isabella232/hw_microRusEfi/microRusEfi.kicad_pcb

## KiCad design microRusEfi.kicad_pcb (2019-09-02)

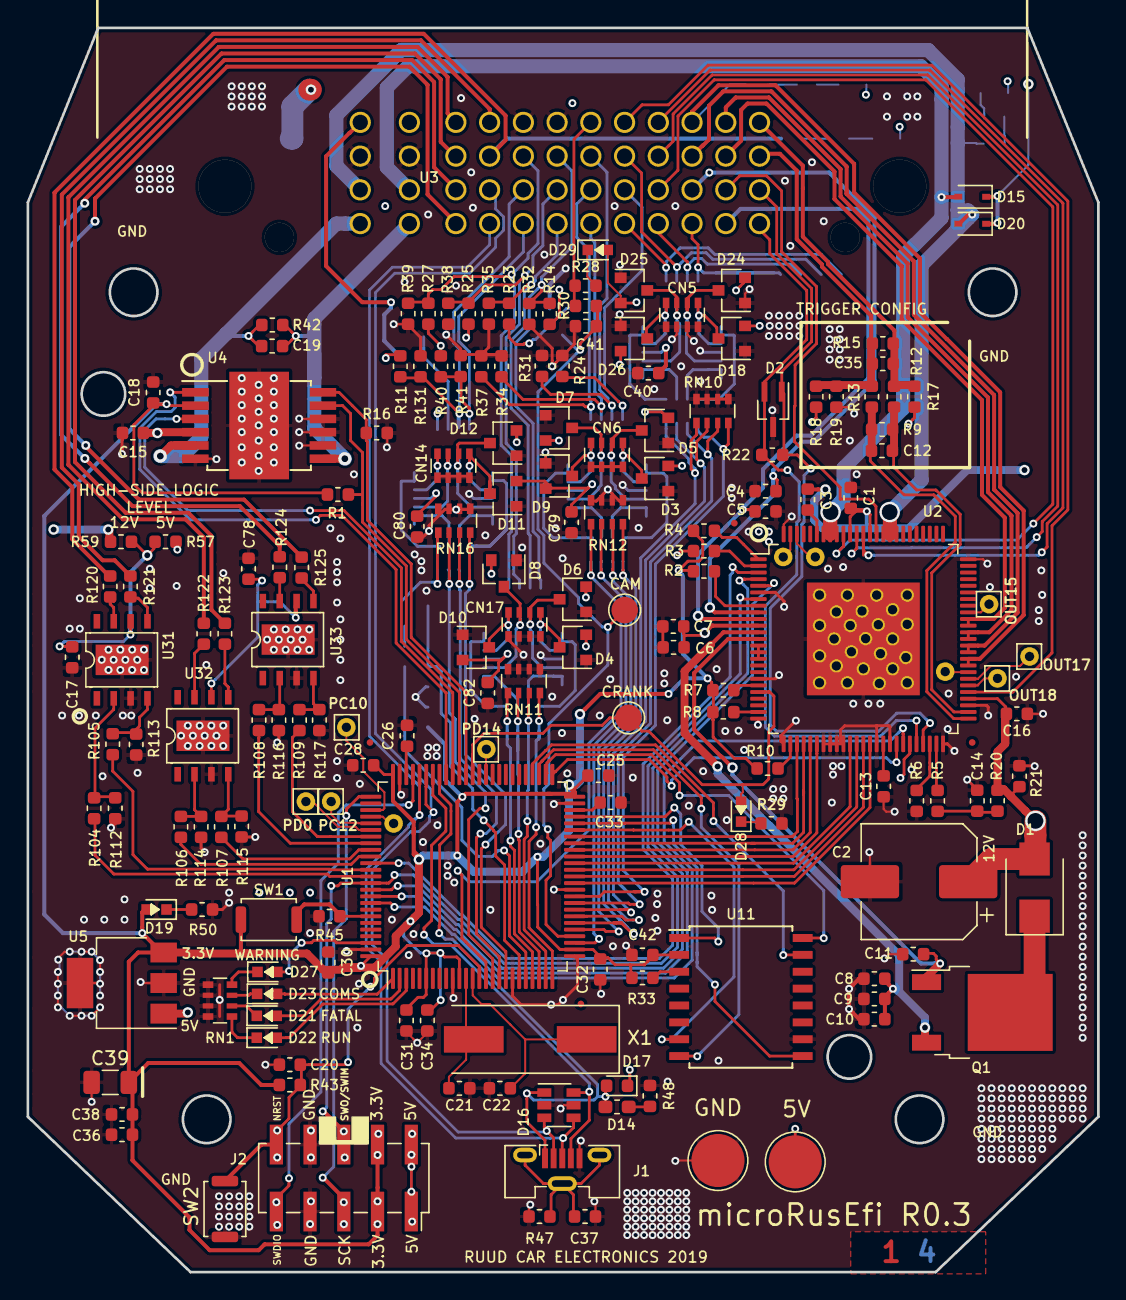
[picture p1: board microRusEfi.kicad_pcb from above]

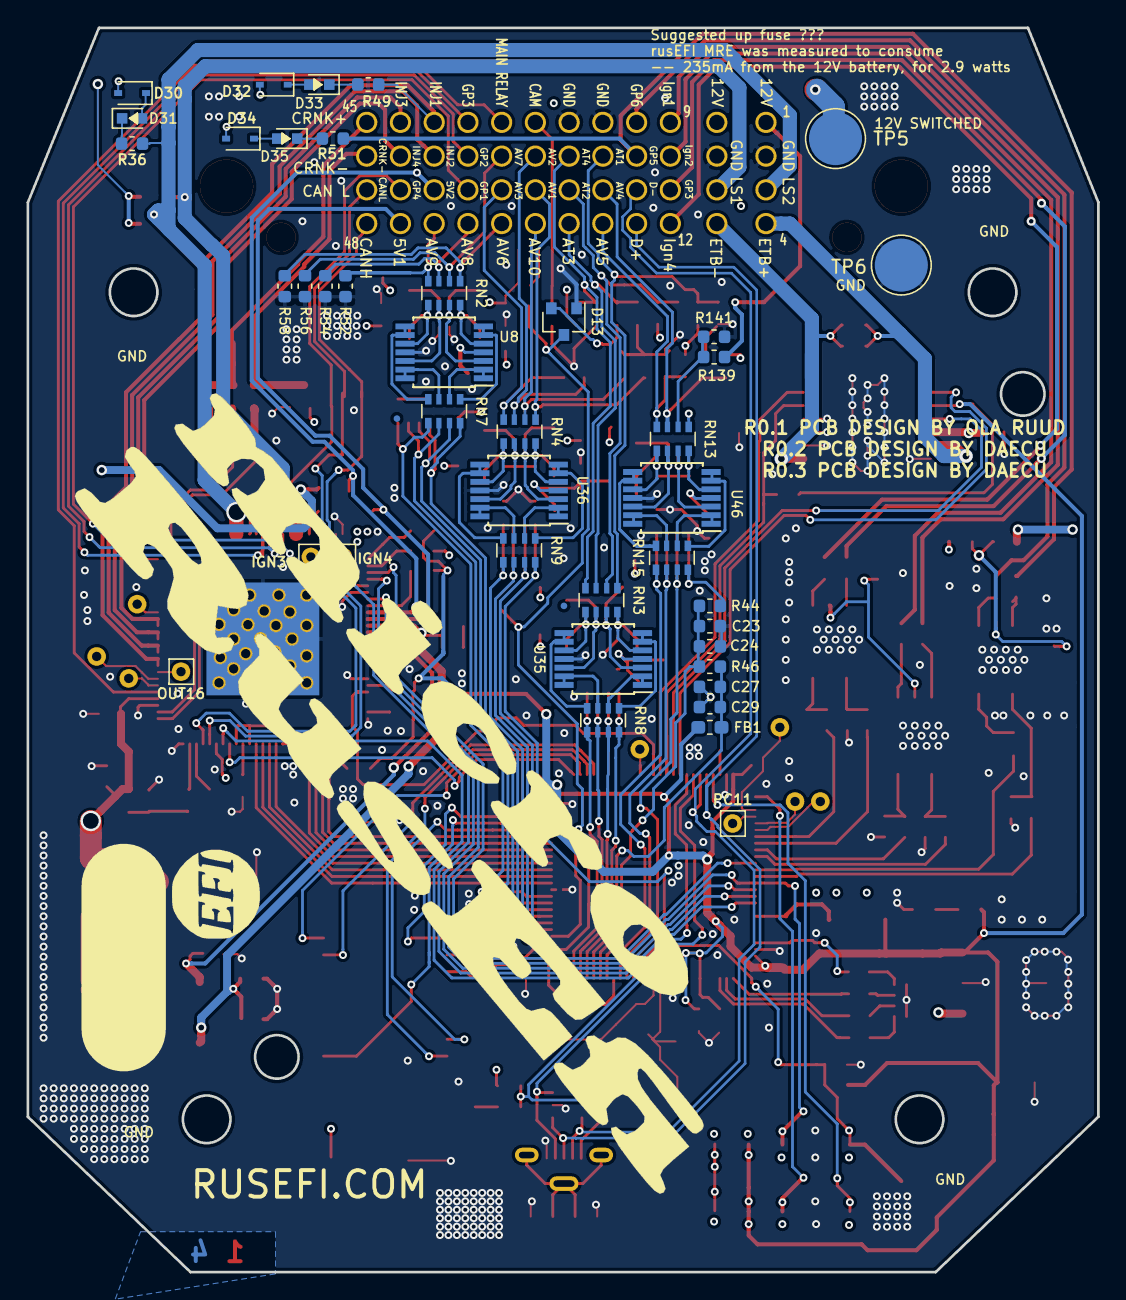
[picture p2: board microRusEfi.kicad_pcb from below]

Board: 4 copper layers, 80.6 x 93.7 mm, 222 parts (44 on the bottom side), 202 nets.

Parts:
C1, C6, C10, C13, C14, C15, C16, C18, C37, C38, C42: 100nF; C_0603_1608Metric
C2: 100UF 50V; CP_Elec_8x10.5
C3, C11: 4.7nF; C_0603_1608Metric
C4, C5: 470nF; C_0603_1608Metric
C7, C8, C9: 10uF; C_0603_1608Metric
C12, C35, C41: 1nF; C_0603_1608Metric
C17, C19, C20, C24, C28, C29, C30, C31, C32, C33, C34, C40, C78, C79, C80, C82: 10nF; C_0603_1608Metric
C21, C22: 4.7pF; C_0603_1608Metric
C23, C27, C36: 1uF; C_0603_1608Metric
C25, C26: 2.2uF; C_0603_1608Metric
C39: 15uF; C_1206_3216Metric
CN5, CN6, CN14, CN17: 10nF; R_Array_Convex_4x0603
D1: MBRS3200T3G; D_SMB
D2: PESD1CAN-UX; SOT-323_SC-70_Handsoldering
D3, D4, D5, D6, D7, D8, D9, D10, D11, D12, D13, D18, D24, D25, D26: BAS70-04; SOT-23
D14: LED-GREEN; C_0603_1608Metric_Pad1.05x0.95mm_HandSolder
D15, D20, D30, D32, D34: NSR0530HT; D_SOD-323
D16: ESDA6V1BC6; SOT-23-6
D17: DIODESCH; D_0603_1608Metric
D19, D21, D31, D33, D35: LED-RED; LED-0603-rusEFI
D22: LED-GRN; LED-0603-rusEFI
D23, D28, D29: LED-BLUE; LED-0603-rusEFI
D27: LED-ORG; LED-0603-rusEFI
FB1: FILTER; R_0603_1608Metric_Pad1.05x0.95mm_HandSolder
FID1, FID2, FID3, FID4, FID5, FID6: Fiducial; Fiducial_0.5mm_Mask1mm
IGN3: IGN3; Pin_D0.7mm_L6.5mm_W1.8mm_FlatFork
IGN4: IGN4; Pin_D0.7mm_L6.5mm_W1.8mm_FlatFork
J1: USB_B_Micro; USB_Micro-B_Molex-105133-0031
J2: Conn_02x05_Odd_Even; PinSocket_2x05_P2.54mm_Vertical_SMD
LOGO1: DNP; LogoMRE
LOGO2: DNP; LOGO
NT1, NT2: Net-Tie_2; Net-Tie_2_8.5mil
OUT15: OUT15; Pin_D0.7mm_L6.5mm_W1.8mm_FlatFork
OUT16: OUT16; Pin_D0.7mm_L6.5mm_W1.8mm_FlatFork
OUT17: OUT17; Pin_D0.7mm_L6.5mm_W1.8mm_FlatFork
OUT18: OUT18; Pin_D0.7mm_L6.5mm_W1.8mm_FlatFork
PC10: PC10; Pin_D0.7mm_L6.5mm_W1.8mm_FlatFork
PC11: PC11; Pin_D0.7mm_L6.5mm_W1.8mm_FlatFork
PC12: PC12; Pin_D0.7mm_L6.5mm_W1.8mm_FlatFork
PD0: PD0; Pin_D0.7mm_L6.5mm_W1.8mm_FlatFork
PD14: PD14; Pin_D0.7mm_L6.5mm_W1.8mm_FlatFork
Q1: IPD30N06S2L-23; TO-252-2
R1, R12, R13, R16, R33, R43, R45, R141: 10k; R_0603_1608Metric
R2, R3, R4, R8, R10, R42: 4.7k; R_0603_1608Metric
R5, R6, R7, R44, R59: 0R; R_0603_1608Metric
R9: 5.11k; R_0603_1608Metric
R11, R17, R18, R19, R40, R46, R57: DNP; R_0603_1608Metric
R14, R20, R21, R23, R25, R27: 2.7k; R_0603_1608Metric
R15: 15k; R_0603_1608Metric
R22: 120; R_0603_1608Metric
R24, R31, R32, R34, R35, R37, R38, R39, R41, R52, R54, R56, R58, R131: 500k; R_0603_1608Metric
R28: 2.2k; R_0603_1608Metric
R29, R36, R48, R49, R51, R112, R113, R114, R115, R116, R117: 1k; R_0603_1608Metric
R30: 33k; R_0603_1608Metric
R47: 100k; R_0603_1608Metric
R50: 680; R_0603_1608Metric
R104, R105, R106, R107, R108, R109: 20R; R_0603_1608Metric
R120, R121, R122, R123, R124, R125: 100; R_0603_1608Metric
R139: 39k; R_0603_1608Metric
RN1, RN7, RN8, RN9, RN15: 1k; R_Array_Convex_4x0603
RN2, RN3, RN4, RN13: 10k; R_Array_Convex_4x0603
RN10, RN11, RN12, RN16: 1.5k; R_Array_Convex_4x0603
SW1, SW2: SW_Push; SW_Push_SPST_NO_Alps_SKRK
TP1, TP5: 5V; TestPoint_Pad_D4.0mm
TP2, TP6: GND; TestPoint_Pad_D4.0mm
TP3, TP4: TP; TestPoint_Pad_D2.0mm
U1: STM32F767VITx; LQFP-100_14x14mm_P0.5mm
U2: TLE8888QK; LQFP-100_14x14mm_P0.5mm_THERMAL
U3: Molex_48_pin; Molex_48
U4: TLE9201SG; Infineon_PG-DSO-12-11
U5: LM2937; SOT-223
U8, U35, U36, U46: MCP6004; TSSOP-14_4.4x5mm_P0.65mm
U11: IS25WP256D-xM; SOIC-16W_7.5x10.3mm_P1.27mm
U31, U32, U33: TC4427; DFN-8-1EP_6x5mm_P1.27mm_EP4x2mm
X1: 8MHz; Crystal_SMD_HC49-SD

Connections:
/5V: C6.1, C7.1, C40.1, C78.1, C79.1, C80.1, C82.1, D3.2, D4.2, D5.2, D6.2, D7.2, D8.2, D9.2, D10.2, D11.2, D12.2, D13.2, D17.1, D18.2, D24.2, D25.2, D26.2, D29.2, D30.2, D32.2, D34.2, J2.1, J2.2, R3.2, R11.2, R14.2, R17.1, R18.1, R23.2, R25.2, R27.2, R40.2, R57.2, RN13.1, TP1.1, U2.11, U2.45, U5.1, U8.4, U32.6, U33.6, U35.4, U36.4, U46.4
/5V1: C5.1, U2.10, U3.44
/5V2: C4.1, U2.9, U3.39
/12V-SWITCH: C1.1, C2.1, C3.1, C15.1, C16.1, D1.2, D15.1, D20.1, R20.2, R21.2, R59.1, R139.2, TP5.1, U2.54, U2.87, U2.90, U3.1, U3.5, U4.4
/AT1: R27.1, R39.1, RN3.1, U3.18
/AT1_MCU: RN8.8, RN11.1, U1.22
/AT2: R25.1, R38.1, RN3.2, U3.23
/AT2_MCU: RN8.7, RN11.2, U1.23
/AT3: R23.1, R35.1, RN3.3, U3.24
/AT3_MCU: RN8.6, RN11.3, U1.24
/AT4: R14.1, R32.1, RN3.4, U3.22
/AT4_MCU: RN8.5, RN11.4, U1.25
/AV1: R37.1, RN4.1, U3.27
/AV1_MCU: RN9.8, RN12.1, U1.15
/AV2: R31.1, RN4.3, U3.26
/AV2_MCU: RN9.6, RN12.3, U1.30
/AV3: R24.1, RN4.4, U3.31
/AV3_MCU: RN9.5, RN12.4, U1.31
/AV4: R11.1, R131.1, RN13.3, U3.19
/AV4_MCU: RN15.6, RN16.3, U1.17
/AV5: R40.1, R41.1, RN13.4, U3.20
/AV5_MCU: RN15.5, RN16.4, U1.18
/AV6: R58.1, RN2.1, U3.32
/AV6_MCU: RN7.8, RN10.1, U1.32
/AV7: R56.1, RN2.2, U3.30
/AV7_MCU: RN7.7, RN10.2, U1.33
/AV8: R54.1, RN2.3, U3.36
/AV8_MCU: RN7.6, RN10.3, U1.34
/AV9: R52.1, RN2.4, U3.40
/AV9_MCU: RN7.5, RN10.4, U1.35
/AV10: R34.1, RN4.2, U3.28
/AV10_MCU: RN9.7, RN12.2, U1.28
/CAM_MCU: C41.1, D13.3, R30.1, TP3.1, U1.29
/CAM_SENSOR: R28.1, R30.2, U3.25
/CANH: D2.2, R22.1, U2.46, U3.48
/CANL: D2.1, R22.2, U2.47, U3.47
/CRANK: D28.2, TP4.1, U1.63, U2.21
/CRNK+: C35.1, R12.1, R15.1, R17.2, U3.45
/CRNK-: C35.2, R13.1, R15.2, R18.2, R19.2, U3.46
/CS_TLE: U1.86, U2.3
/E-THROTTLE+: C19.2, R42.2, U3.4, U4.5
/E-THROTTLE-: C19.1, R42.1, U3.8, U4.7
/FlashMemory/CS: U1.45, U11.7
/FlashMemory/HOLD: U1.47, U11.1
/GP1: U2.91, U3.35
/GP2: U2.89, U3.34
/GP3: U2.88, U3.33
/GP4: U2.86, U3.43
/GP5: R51.2, R120.1, U3.14
/GP6: R121.1, U3.13
/H-BRIDGE/DIR: U1.67, U4.1
/H-BRIDGE/DIS: R1.2, U1.65, U4.11
/INJECTOR-1: R49.2, U2.59, U2.60, U3.37
/INJECTOR-2: U2.61, U2.62, U3.38
/INJECTOR-3: U2.63, U2.64, U3.41
/INJECTOR-4: U2.65, U2.66, U3.42
/Ign1: R122.1, U3.9
/Ign2: R123.1, U3.10
/Ign3: R124.1, U3.11
/Ign4: R125.1, U3.12
/LS1: D15.2, U2.92, U2.93, U2.94, U3.7
/LS2: D20.2, R36.2, U2.83, U2.84, U2.85, U3.3
/MAIN_RELAY: U2.55, U3.29
/MCU/NRST: C20.2, J2.10, R43.2, SW2.1, U1.14
/MCU/PA9: D14.2, D16.1, D17.2, J1.1, NT1.2
/MCU/PA10: D16.6, J1.4, U1.69
/MCU/PA13: J2.9, U1.72
/MCU/PA14: J2.5, U1.76
/MCU/PB10: U1.46, U11.9
/MCU/PB13: U1.52, U11.16
/MCU/PB14: U1.53, U11.8
/MCU/PB15: U1.54, U11.15
/MCU/PC7: R16.1, U1.64, U4.12
/MCU/PC9: U1.66, U4.3
/MCU/PC10: PC10.1, U1.78
/MCU/PC11: PC11.1, U1.79
/MCU/PC12: PC12.1, U1.80
/MCU/PD0: PD0.1, U1.81
/MCU/PD14: PD14.1, U1.61
/MCU/shield: C37.1, J1.6, R47.1
/PE1: D27.2, U1.98
/PE2: D23.2, U1.1
/PE3: D21.2, U1.2
/PE4: D22.2, U1.3
/SCK: J2.6, U1.89, U2.7
/SI: U1.91, U2.5
/SO: U1.90, U2.4
/TLE8888-1QK/CAN_RX: U1.51, U2.43
/TLE8888-1QK/CAN_TX: U1.92, U2.44
/TLE8888-1QK/IGN_EN: R10.2, U2.27
/TLE8888-1QK/IGN_OUT_3: IGN3.1, U2.98
/TLE8888-1QK/IGN_OUT_4: IGN4.1, U2.99
/TLE8888-1QK/INJ_EN: R8.2, U2.24
/TLE8888-1QK/INJ_IN_1: U1.44, U2.28
/TLE8888-1QK/INJ_IN_2: U1.43, U2.29
/TLE8888-1QK/INJ_IN_3: U1.42, U2.30
/TLE8888-1QK/INJ_IN_4: U1.41, U2.31
/TLE8888-1QK/IN_9: U1.40, U2.36
/TLE8888-1QK/IN_10: U1.39, U2.37
/TLE8888-1QK/IN_11: U1.38, U2.38
/TLE8888-1QK/IN_12: U1.37, U2.39
/TLE8888-1QK/KEY: R5.2, U2.49
/TLE8888-1QK/OUT_7: U2.14, U2.15, U2.16
/TLE8888-1QK/OUT_15: OUT15.1, U2.67
/TLE8888-1QK/OUT_16: OUT16.1, U2.58
/TLE8888-1QK/OUT_17: OUT17.1, U2.57
/TLE8888-1QK/OUT_18: OUT18.1, U2.56
/TLE8888-1QK/VDDIO: R7.2, U2.20
/TLE8888-1QK/WAKE: R6.2, U2.48
/USB_D+: D16.4, J1.3, U1.71, U3.16
/USB_D-: D16.3, J1.2, U1.70, U3.15
/VDD: C18.1, C28.2, C30.2, C31.2, C32.2, C33.2, C34.2, C36.2, C38.1, C39.2, C42.2, D19.2, FB1.1, J2.3, J2.4, R1.1, R2.2, R4.2, R7.1, R8.1, R10.1, R33.1, R43.1, SW1.1, U1.6, U1.11, U1.27, U1.50, U1.75, U1.100, U4.2, U5.3, U11.2
/Vbat_MCU: RN15.7, RN16.2, U1.16
/Vref: R44.1, RN15.8, RN16.1
/hi-lo/GP5_MCU: R104.2, U1.88
/hi-lo/GP6_MCU: R105.2, U1.87
/hi-lo/Ign1_MCU: R106.2, U1.85
/hi-lo/Ign2_MCU: R107.2, U1.84
/hi-lo/Ign3_MCU: R108.2, U1.83
/hi-lo/Ign4_MCU: R109.2, U1.82
GND: C1.2, C2.2, C4.2, C5.2, C6.2, C7.2, C8.2, C9.2, C10.2, C11.2, C13.2, C14.2, C15.2, C16.2, C17.2, C18.2, C20.1, C21.2, C22.2, C23.1, C24.1, C25.2, C26.2, C27.1, C28.1, C29.1, C30.1, C31.1, C32.1, C33.1, C34.1, C36.1, C37.2, C38.2, C39.1, C40.2, C41.2, C42.1, C78.2, C79.2, C80.2, C82.2, CN5.5, CN5.6, CN5.7, CN5.8, CN6.5, CN6.6, CN6.7, CN6.8, CN14.5, CN14.6, CN14.7, CN14.8, CN17.5, CN17.6, CN17.7, CN17.8, D2.3, D3.1, D4.1, D5.1, D6.1, D7.1, D8.1, D9.1, D10.1, D11.1, D12.1, D13.1, D16.2, D16.5, D18.1, D24.1, D25.1, D26.1, J1.5, J2.7, J2.8, NT2.2, R6.1, R16.2, R19.1, R21.1, R24.2, R29.2, R31.2, R32.2, R34.2, R35.2, R37.2, R38.2, R39.2, R41.2, R45.2, R47.2, R48.1, R50.1, R52.2, R54.2, R56.2, R58.2, R112.1, R113.1, R114.1, R115.1, R116.1, R117.1, R131.2, R141.2, RN1.5, RN1.6, RN1.7, RN1.8, RN10.5, RN10.6, RN10.7, RN10.8, RN11.5, RN11.6, RN11.7, RN11.8, RN12.5, RN12.6, RN12.7, RN12.8, RN16.5, RN16.6, RN16.7, RN16.8, SW2.2, TP2.1, TP6.1, U1.10, U1.19, U1.26, U1.49, U1.74, U1.99, U2.6, U2.19, U2.25, U2.26, U2.32, U2.33, U2.34, U2.35, U2.40, U2.42, U2.50, U2.53, U2.75, U2.100, U2.101, U3.2, U3.6, U3.17, U3.21, U4.6, U4.8, U4.9, U4.10, U4.13, U5.2, U8.11, U11.10, U31.3, U31.9, U32.3, U32.9, U33.3, U33.9, U35.11, U36.11, U46.11
unnamed: C3.2, U2.95
unnamed: C8.1, C9.1, C10.1, Q1.3, U2.12
unnamed: C11.1, Q1.1, U2.13
unnamed: C12.1, R9.1, R12.2, U2.52
unnamed: C12.2, R9.2, R13.2, U2.51
unnamed: C13.1, U2.41
unnamed: C14.1, R5.1, R20.1
unnamed: C17.1, R57.1, R59.2, U31.6
unnamed: C21.1, U1.12, X1.2
unnamed: C22.1, U1.13, X1.1
unnamed: C23.2, C24.2, R44.2, R46.1, U1.20
unnamed: C25.1, U1.48
unnamed: C26.1, U1.73
unnamed: C27.2, C29.2, FB1.2, R46.2, U1.21
unnamed: CN5.1, D18.3, RN2.5, U8.10
unnamed: CN5.2, D24.3, RN2.6, U8.12
unnamed: CN5.3, D25.3, RN2.7, U8.3
unnamed: CN5.4, D26.3, RN2.8, U8.5
unnamed: CN6.1, D3.3, RN4.5, U36.10
unnamed: CN6.2, D5.3, RN4.6, U36.12
unnamed: CN6.3, D7.3, RN4.7, U36.3
unnamed: CN6.4, D9.3, RN4.8, U36.5
unnamed: CN14.1, D11.3, RN13.5, U46.10
unnamed: CN14.2, D12.3, RN13.6, U46.12
unnamed: CN14.3, RN13.7, U46.3
unnamed: CN14.4, RN13.8, U46.5
unnamed: CN17.1, D4.3, RN3.5, U35.10
unnamed: CN17.2, D6.3, RN3.6, U35.12
unnamed: CN17.3, D8.3, RN3.7, U35.3
unnamed: CN17.4, D10.3, RN3.8, U35.5
unnamed: D1.1, Q1.2
unnamed: D14.1, R48.2
unnamed: D19.1, R50.2
unnamed: D21.1, RN1.2
unnamed: D22.1, RN1.1
unnamed: D23.1, RN1.3
unnamed: D27.1, RN1.4
unnamed: D28.1, R29.1
unnamed: D29.1, R28.2
unnamed: D30.1, D31.2
unnamed: D31.1, R36.1
unnamed: D32.1, D33.2
unnamed: D33.1, R49.1
unnamed: D34.1, D35.2
unnamed: D35.1, R51.1
unnamed: NT1.1, U1.68
unnamed: NT2.1, U1.36
unnamed: R2.1, U2.8
unnamed: R3.1, U2.2
unnamed: R4.1, U2.1
unnamed: R33.2, U11.3
unnamed: R45.1, SW1.2, U1.94
unnamed: R104.1, R112.2, U31.2
unnamed: R105.1, R113.2, U31.4
unnamed: R106.1, R114.2, U32.2
unnamed: R107.1, R115.2, U32.4
unnamed: R108.1, R116.2, U33.2
unnamed: R109.1, R117.2, U33.4
unnamed: R120.2, U31.7
unnamed: R121.2, U31.5
unnamed: R122.2, U32.7
unnamed: R123.2, U32.5
unnamed: R124.2, U33.7
unnamed: R125.2, U33.5
unnamed: R139.1, R141.1, RN13.2
unnamed: RN7.1, U8.6, U8.7
unnamed: RN7.2, U8.1, U8.2
unnamed: RN7.3, U8.13, U8.14
unnamed: RN7.4, U8.8, U8.9
unnamed: RN8.1, U35.6, U35.7
unnamed: RN8.2, U35.1, U35.2
unnamed: RN8.3, U35.13, U35.14
unnamed: RN8.4, U35.8, U35.9
unnamed: RN9.1, U36.6, U36.7
unnamed: RN9.2, U36.1, U36.2
unnamed: RN9.3, U36.13, U36.14
unnamed: RN9.4, U36.8, U36.9
unnamed: RN15.1, U46.6, U46.7
unnamed: RN15.2, U46.1, U46.2
unnamed: RN15.3, U46.13, U46.14
unnamed: RN15.4, U46.8, U46.9
